LeoHougaard/robot-research-playground/hardware/electronics/watchdog-circuit.png

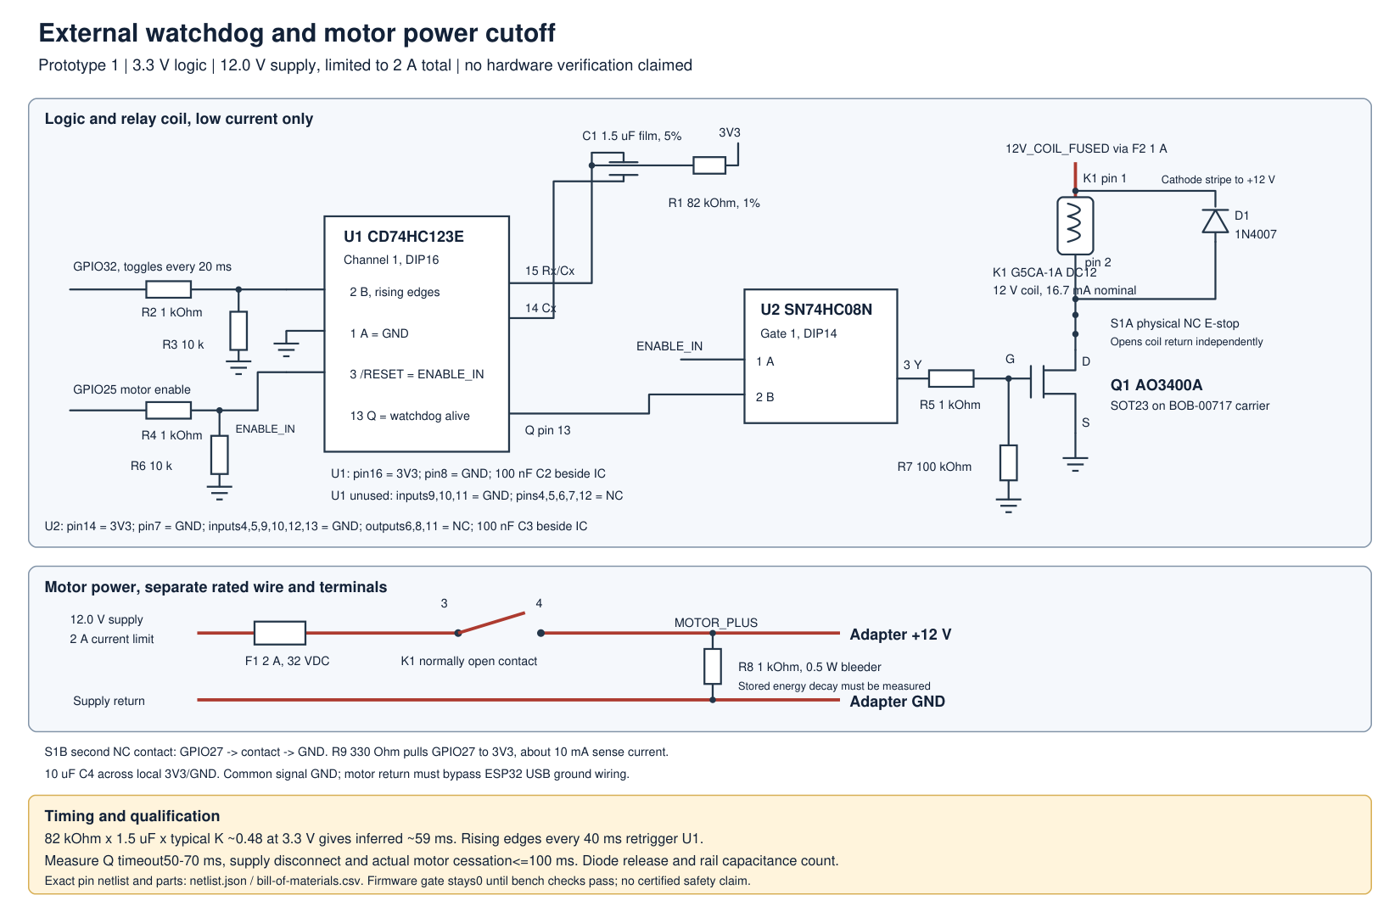
hardware/electronics/watchdog-circuit.png
