LeoHougaard/robot-research-playground/hardware/freecad/robot/previews/native_arena_top.png

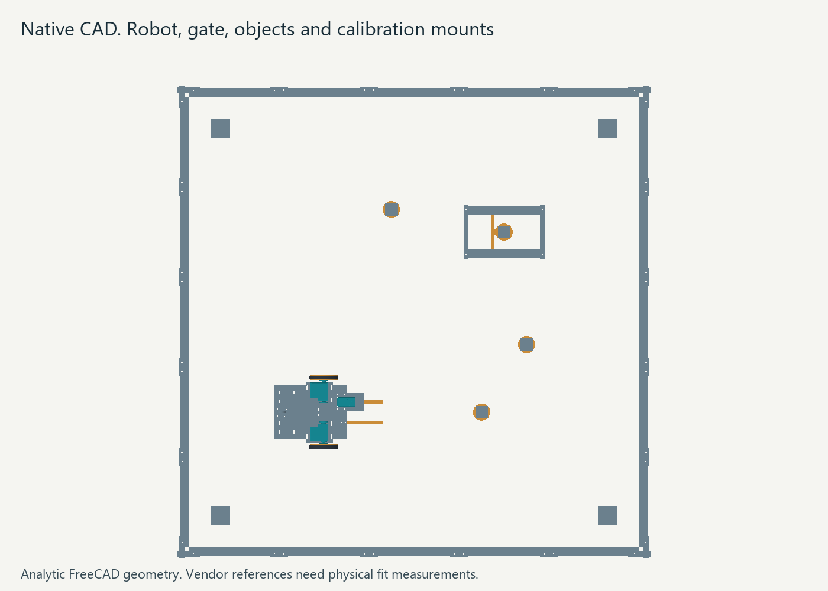
hardware/freecad/robot/previews/native_arena_top.png
