LeoHougaard/robot-research-playground/hardware/markers/aruco-markers-a4-300dpi.png

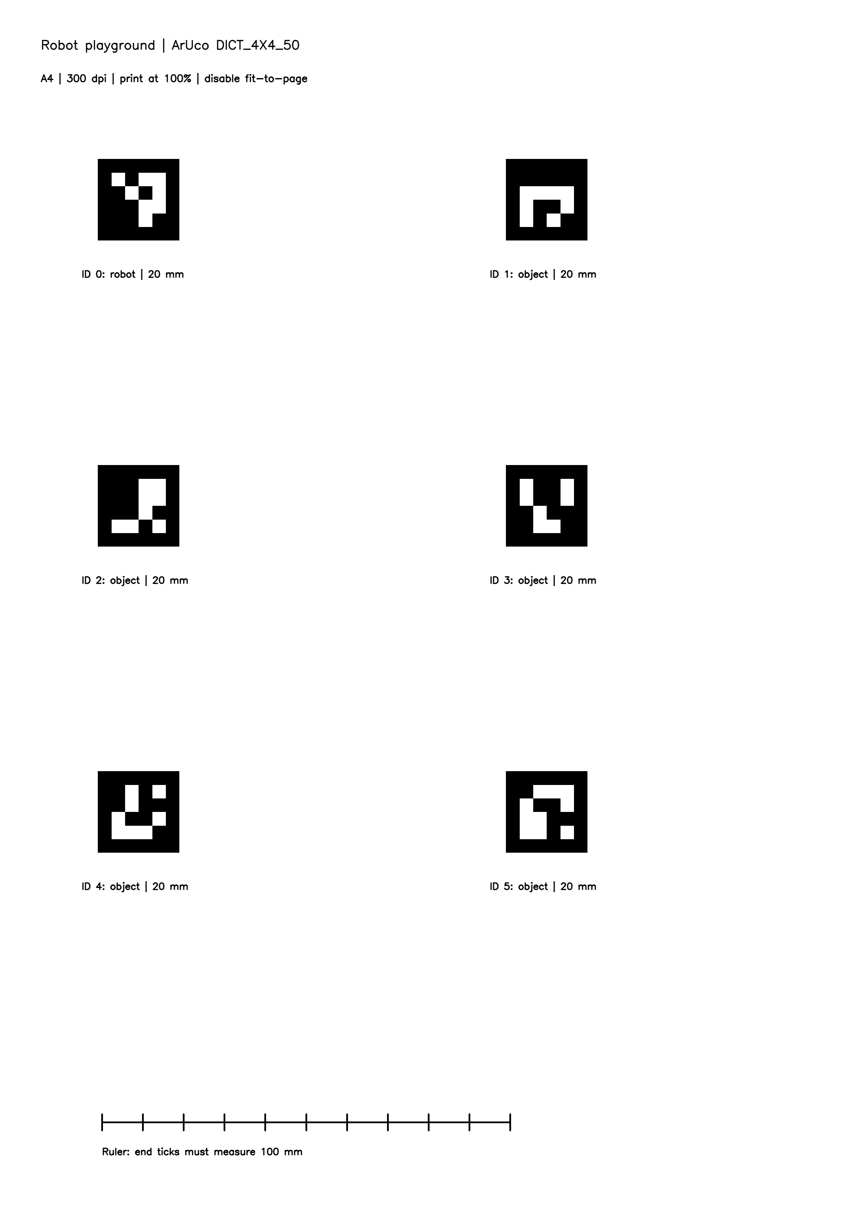
hardware/markers/aruco-markers-a4-300dpi.png
