LeoHougaard/robot-research-playground/hardware/markers/marker-0-20mm-300dpi.png

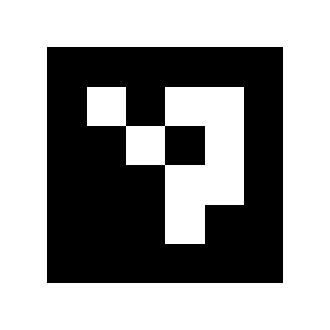
hardware/markers/marker-0-20mm-300dpi.png
