LeoHougaard/robot-research-playground/hardware/markers/marker-1-20mm-300dpi.png

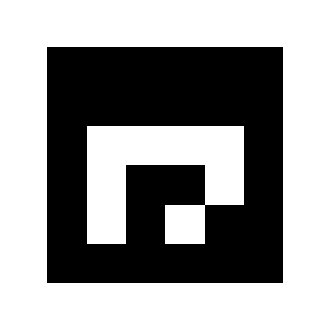
hardware/markers/marker-1-20mm-300dpi.png
