LeoHougaard/robot-research-playground/hardware/markers/marker-5-20mm-300dpi.png

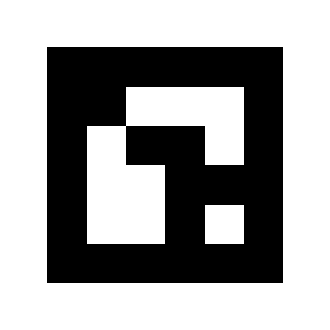
hardware/markers/marker-5-20mm-300dpi.png
