LeoHougaard/robot-research-playground/hardware/electronics/bill-of-materials.csv

Reference | Quantity | Manufacturer | Part number | Specification | Notes | Primary source
U1 | 1 | Texas Instruments | CD74HC123E | PDIP16 HC retriggerable monostable 2-6V | Use HC not HCT; power from ESP32 3.3V | https://www.ti.com/product/CD74HC123/part-details/CD74HC123E
U2 | 1 | Texas Instruments | SN74HC08N | PDIP14 quad AND gate 2-6V | Use HC not HCT; power from ESP32 3.3V | https://www.ti.com/product/SN74HC08/part-details/SN74HC08N
Q1 | 1 | Alpha and Omega Semiconductor | AO3400A | 30V N-channel MOSFET with Rds specified at 2.5V | SOT23 on carrier; switches only relay coil not motors | https://www.aosmd.com/products/mosfets/low-voltage-mosfets-12v-30v/ao3400a
Q1 carrier | 1 | SparkFun | BOB-00717 | SOT23 to DIP adapter | Verify carrier-pad continuity to actual G/S/D before soldering | https://www.sparkfun.com/sparkfun-sot23-to-dip-adapter.html
K1 | 1 | Omron / Aratas | G5CA-1A DC12 | 12V 16.7mA coil; SPST-NO 10A at30VDC resistive | 3A DC inductive rating; prototype supply limited to2A total | https://omronfs.omron.com/en_US/ecb/products/pdf/en-g5ca.pdf
D1 | 1 | Vishay | 1N4007-E3/54 | 1A axial diode | Cathode stripe to coil+12V; anode to coil low side BEFORE E-stop | https://www.vishay.com/docs/88503/1n4001.pdf
S1 | 1 | Omron | A22E-M-02 | Latching turn-reset E-stop with two NC contacts | One NC opens coil return; second NC connects GPIO27 to GND | https://www.fa.omron.co.jp/product/item/A22E-M-02/
S2 | 1 | Adafruit | 1505 | Black normally-open momentary 16mm panel button; max shaft15.56mm totalheight29.4mm | GPIO26 to GND with firmware internal pullup; nominal16mm panel hole needs physical fit check; label PRESS TO AUTHORIZE; fresh press grants window then host arm required | https://www.adafruit.com/product/1505
C1 | 1 | TDK | B32529C0155J000 | 1.5uF 63V film +/-5%; 5mm lead spacing | Timing capacitor BETWEEN U1 pins14 and15; never substitute bulk electrolytic without requalification | https://www.tdk-electronics.tdk.com/inf/20/20/db/fc_2009/B32520_529.pdf
R1 | 1 | Commodity | 82k axial metal-film 1% | 0.25W minimum | Timing resistor from U1 pin15 to3.3V; measured timing gate required | https://www.ti.com/lit/ds/symlink/cd74hc123.pdf
R2 R4 R5 | 3 | Commodity | 1k axial metal-film 1% | 0.25W minimum | GPIO32 series; GPIO25 series; MOSFET gate series
R3 R6 | 2 | Commodity | 10k axial metal-film 1% | 0.25W minimum | Pull GPIO32 input and enable/reset input down at logic ICs
R7 | 1 | Commodity | 100k axial metal-film 1% | 0.25W minimum | Gate-to-source pulldown physically beside Q1
R8 | 1 | Commodity | 1k resistor 5% | 0.5W minimum | Motor rail bleeder; does not prove fast capacitor discharge
R9 | 1 | Commodity | 330ohm resistor 5% | 0.25W minimum | External GPIO27 pullup to3.3V provides about10mA NC sense current; measure contact behavior
C2 C3 | 2 | Commodity | 100nF X7R ceramic radial | 16V minimum | One per logic IC beside supply pins
C4 | 1 | Commodity | 10uF electrolytic radial | 10V minimum | 3.3V local bulk bypass; correct polarity
F1 | 1 | Littelfuse | 0297002.WXNV | 2A MINI blade fuse rated32VDC | Motor positive branch; do not raise commissioning supply above2A | https://www.littelfuse.com/assetdocs/littelfuse-datasheet-297-mini32v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
F2 | 1 | Littelfuse | 0287001.PXCN | 1A ATOF blade fuse rated32VDC | Separate coil positive branch and appropriate holder | https://www.littelfuse.com/products/fuses-overcurrent-protection/fuses/automotive-fuses/blade-fuses-shunt
Construction | 1 | Commodity | Isolated-pad perfboard plus DIP14 and DIP16 sockets | Offboard electronics in enclosure | Motor current runs through soldered heavy wire and rated terminals; no breadboard motor paths
