LeoHougaard/robot-research-playground/hardware/prints/print_manifest.csv

part | quantity | material | orientation
01_horn_fit_coupon | 1 | PETG | flat; compare all four holes to the stock horn
02_hole_clearance_coupon | 1 | PETG | flat; hole sequence left to right 2.5,2.8,3.0,3.2,3.4 mm
03_servo_body_coupon | 1 | PETG | flat; open gap is40.2 mm
04_gate_rail_coupon | 1 | PETG | flat; same retaining lip as full gate, supports under lip
05_gate_runner_coupon | 1 | PETG | flat; slide through coupon channel before printing full gate
10_chassis | 1 | PETG | flat bottom; no supports
11_drive_servo_cradle | 2 | PETG | flat bottom; no supports
12_drive_wheel | 2 | PETG | flat side; no supports
13_tpu_tire | 2 | TPU95A | flat ring; no supports
14_caster_spacer | 1 | PETG | flat; nominal3.9 mm
15_caster_shim_05 | 1 | PETG | flat; optional leveling
16_caster_shim_10 | 1 | PETG | flat; optional leveling
20_moving_jaw | 1 | PETG | flat; no supports
21_fixed_jaw | 1 | PETG | flat jaw bottom; no supports
22_gripper_servo_tower | 1 | PETG | flat bottom; cable-window bridge and strap slots may need supports
30_marker_tower | 1 | PETG | marker plate on bed; turn over for assembly
31_tether_mast | 1 | PETG | upright with brim; support inside eye or print on side with supports
32_overhead_tie_plate | 1 | PETG | flat plate; eye needs support
40_puck | 3 | PETG | flat; vary color by object, keep shape unchanged
41_object_marker_cap | 8 | PETG | plate on bed, stem upward; invert and glue into puck, gate, or calibration socket
42_calibration_marker_base | 4 | PETG | flat; same74 mm tagplane as robot and objects
50_gate_base | 1 | PETG | flat bottom; rail lips need support, remove support from channels
51_gate_slider | 1 | PETG | supports under runners and rear bridge; ensure all support is removable
52_gate_end_stop | 4 | PETG | flat; one block per rail at each end, no supports
60_arena_wall_200 | 20 | PETG | flat foot; inside face at localY=0, foot points outside
61_wall_joiner | 16 | PETG | flat; use on top of adjacent feet
62_arena_corner | 4 | PETG | flat; use on top of feet at frame corners
