LeoHougaard/robot-research-playground/hardware/prints/accessories/print_manifest.csv

part | quantity | material | orientation | stl_path | print_rotation_xyz_deg | print_translation_mm | native_bounds_mm
electronics_box | 1 | PETG | Floor on bed; open box upward | hardware/prints/accessories/electronics_box.stl | [0, 0, 0] | [0, 0, -0.0] | [[0.0, 0.0, 0.0], [200.0, 130.0, 65.0]]
electronics_lid | 1 | PETG | Outer flat face on bed; retaining lip upward | hardware/prints/accessories/electronics_lid.stl | [180, 0, 0] | [0, 0, 3.0] | [[0.0, 0.0, -4.0], [200.0, 130.0, 3.0]]
perfboard_carrier | 1 | PETG | Largest flat face on bed | hardware/prints/accessories/perfboard_carrier.stl | [0, 0, 0] | [0, 0, -0.0] | [[-1.3322676295501878e-15, -3.552713678800501e-15, 0.0], [186.0, 116.0, 4.0]]
camera_plate | 1 | PETG | Largest flat face on bed | hardware/prints/accessories/camera_plate.stl | [0, 0, 0] | [0, 0, -0.0] | [[0.0, 0.0, 0.0], [140.0, 100.0, 8.0]]
beam_clamp_lower | 2 | PETG | Flat outer back on bed; groove upward | hardware/prints/accessories/beam_clamp_lower.stl | [0, 0, 0] | [0, 0, -0.0] | [[0.0, 0.0, 0.0], [80.0, 54.0, 16.0]]
beam_clamp_upper | 2 | PETG | Flat outer back on bed; groove upward | hardware/prints/accessories/beam_clamp_upper.stl | [0, 0, 0] | [0, 0, -0.0] | [[0.0, 0.0, 0.0], [80.0, 54.0, 16.0]]
tether_anchor_plate | 1 | PETG | Flat plate on bed; cord is secondary restraint only | hardware/prints/accessories/tether_anchor_plate.stl | [0, 0, 0] | [0, 0, -0.0] | [[0.0, 0.0, 0.0], [80.0, 30.0, 5.0]]
cable_clamp_lower | 1 | PETG | Flat back on bed; groove upward | hardware/prints/accessories/cable_clamp_lower.stl | [0, 0, 0] | [0, 0, -0.0] | [[-6.439293542825908e-16, 0.0, 0.0], [50.0, 22.0, 8.000000000000014]]
cable_clamp_upper | 1 | PETG | Flat back on bed; groove upward | hardware/prints/accessories/cable_clamp_upper.stl | [0, 0, 0] | [0, 0, -0.0] | [[-6.439293542825908e-16, 0.0, 0.0], [50.0, 22.0, 8.000000000000014]]
estop_panel | 1 | PETG | Flat rear on bed; use supplied Omron locking plate, no printed certification claim | hardware/prints/accessories/estop_panel.stl | [0, 0, 0] | [0, 0, -0.0] | [[0.0, 0.0, 0.0], [120.0, 160.0, 3.0]]
estop_clearance_ring | 1 | PETG | Flat ring on bed; optional low ring, check palm access and twist-release | hardware/prints/accessories/estop_clearance_ring.stl | [0, 0, 0] | [0, 0, -0.0] | [[-47.0, -40.0, 0.0], [47.0, 40.0, 5.000000000000001]]
estop_panel_stand | 1 | PETG | Floor on bed; secure to desk/support; open sides give rear terminal access | hardware/prints/accessories/estop_panel_stand.stl | [0, 0, 0] | [0, 0, -0.0] | [[0.0, 0.0, 0.0], [140.0, 180.0, 76.0]]
terminal_guard | 1 | PETG | Flat floor on bed; low-voltage terminal shielding only | hardware/prints/accessories/terminal_guard.stl | [0, 0, 0] | [0, 0, -0.0] | [[0.0, 0.0, 0.0], [90.0, 24.0, 22.0]]
