LeoHougaard/robot-research-playground/hardware/prints/parts_inventory.png

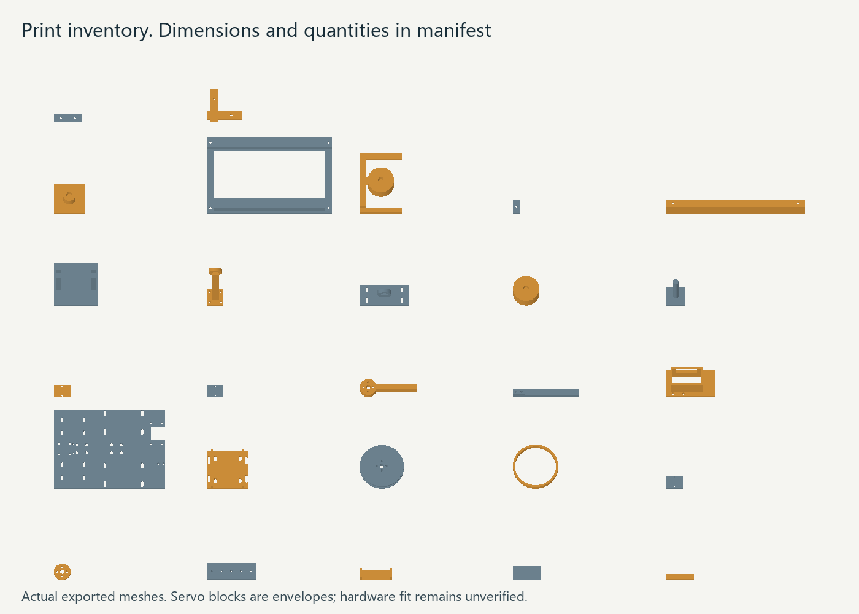
hardware/prints/parts_inventory.png
