LeoHougaard/robot-research-playground/hardware/native/accessories/tether_assembly.FCStd

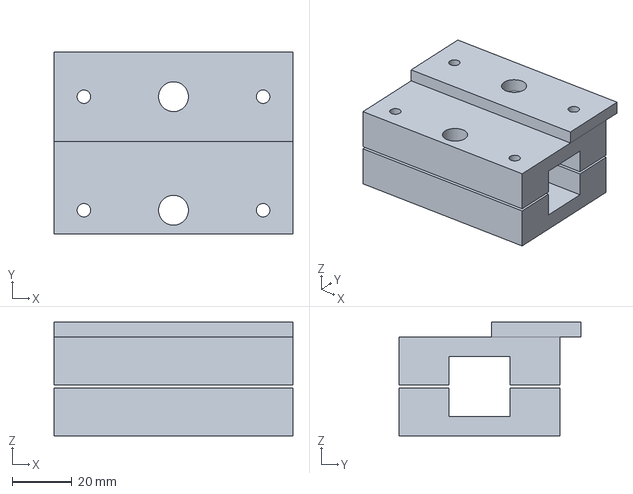
[picture p18: CAD file, 2026-10-13]
hardware/native/accessories/tether_assembly.FCStd
80.0 x 61.0 x 38.0 mm
