LeoHougaard/robot-research-playground/hardware/step/robot/robot_playground_assembly.step

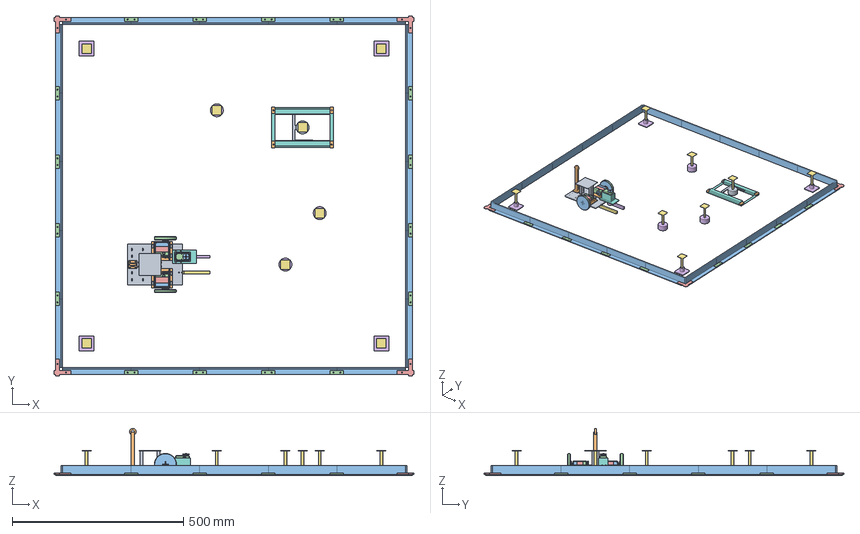
[picture p19: CAD file, 2026-10-13]
hardware/step/robot/robot_playground_assembly.step
1050.0 x 1050.0 x 138.0 mm
10_chassis
11_drive_servo_cradle x 2
12_drive_wheel x 2
13_tpu_tire x 2
14_caster_spacer
20_moving_jaw
21_fixed_jaw
22_gripper_servo_tower
30_marker_tower
31_tether_mast
ST3020 drive servo vendor reference -1 x 3
Pololu950 caster vendor reference
40_puck x 3
41_object_marker_cap x 8
50_gate_base
51_gate_slider
52_gate_end_stop x 4
60_arena_wall_200 x 20
61_wall_joiner x 16
62_arena_corner x 4
42_calibration_marker_base x 4
