LeoHougaard/robot-research-playground/hardware/native/accessories/camera_assembly.FCStd

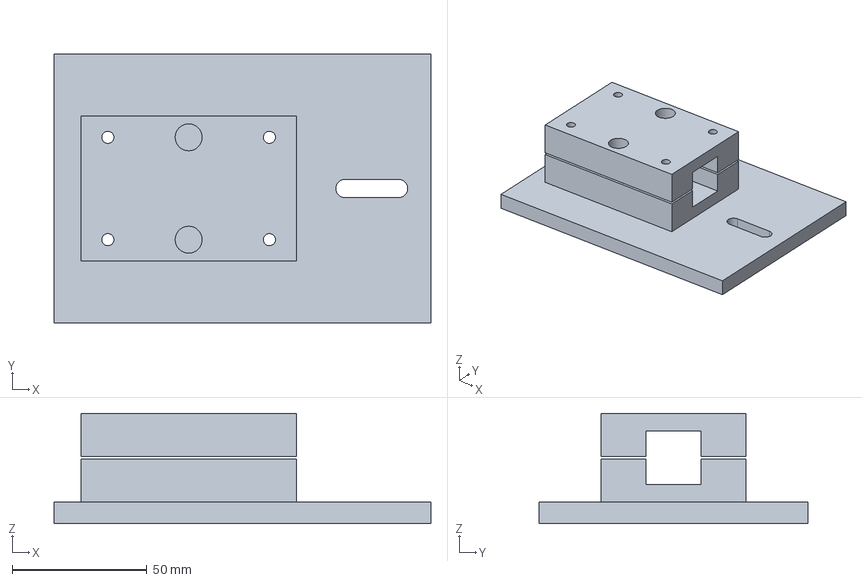
[picture p20: CAD file, 2026-10-13]
hardware/native/accessories/camera_assembly.FCStd
140.0 x 100.0 x 41.0 mm
