LeoHougaard/robot-research-playground/hardware/step/accessories/cable_assembly.step

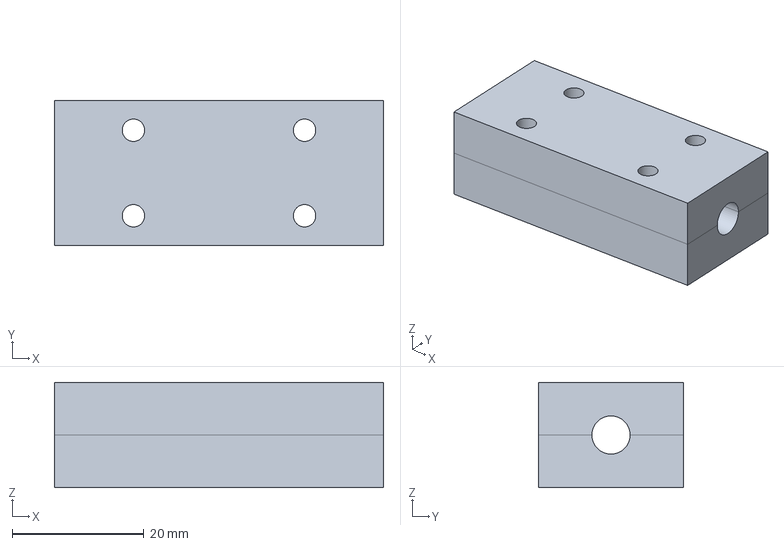
[picture p21: CAD file, 2026-10-13]
hardware/step/accessories/cable_assembly.step
50.0 x 22.0 x 16.0 mm
