LeoHougaard/robot-research-playground/hardware/native/accessories/operator_panel_assembly.FCStd

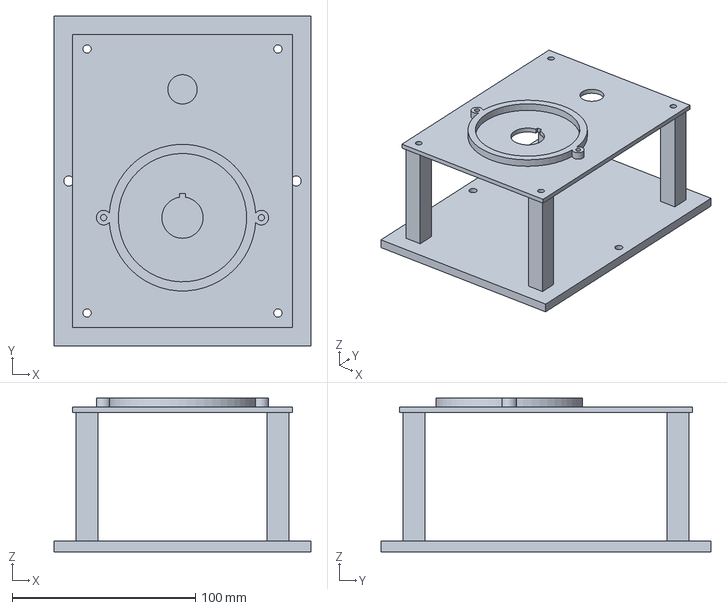
[picture p22: CAD file, 2026-10-13]
hardware/native/accessories/operator_panel_assembly.FCStd
140.0 x 180.0 x 84.0 mm
