LeoHougaard/robot-research-playground/hardware/step/accessories/electronics_assembly.step

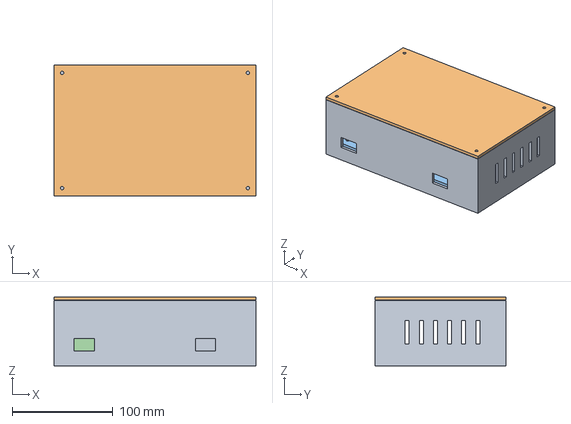
[picture p23: CAD file, 2026-10-13]
hardware/step/accessories/electronics_assembly.step
200.0 x 130.0 x 68.3 mm
