LeoHougaard/robot-research-playground/hardware/freecad/robot/pololu950.step

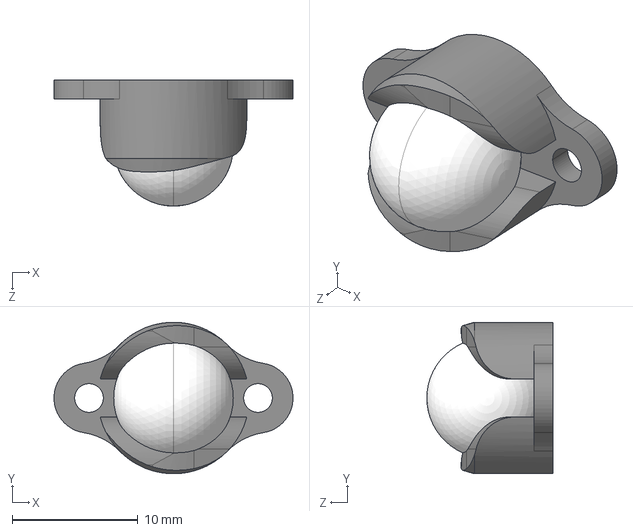
[picture p24: CAD file, 2026-10-13]
hardware/freecad/robot/pololu950.step
19.0 x 12.1 x 10.1 mm
