LeoHougaard/robot-research-playground/hardware/native/accessories/cable_clamp_lower.FCStd

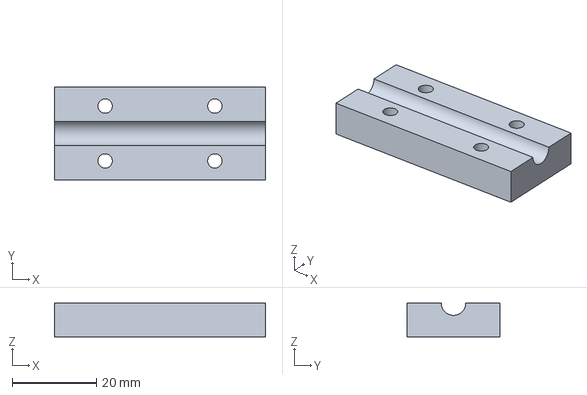
[picture p25: CAD file, 2026-10-13]
hardware/native/accessories/cable_clamp_lower.FCStd
50.0 x 22.0 x 8.00 mm
