LeoHougaard/robot-research-playground/hardware/native/robot/12_drive_wheel.FCStd

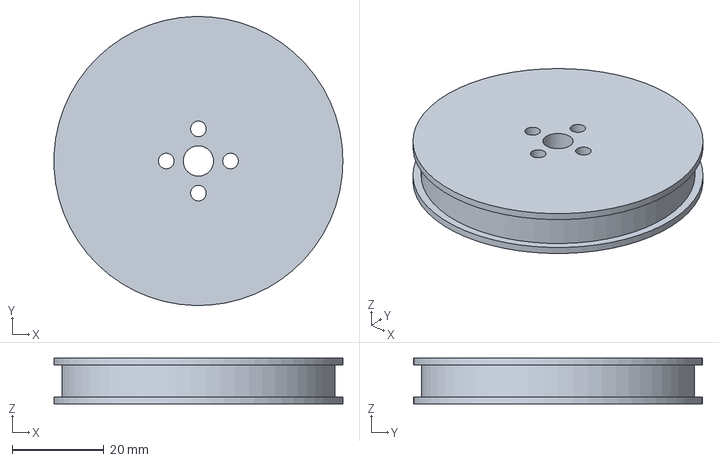
[picture p26: CAD file, 2026-10-13]
hardware/native/robot/12_drive_wheel.FCStd
63.0 x 63.0 x 10.0 mm
