LeoHougaard/robot-research-playground/hardware/step/accessories/electronics_lid.step

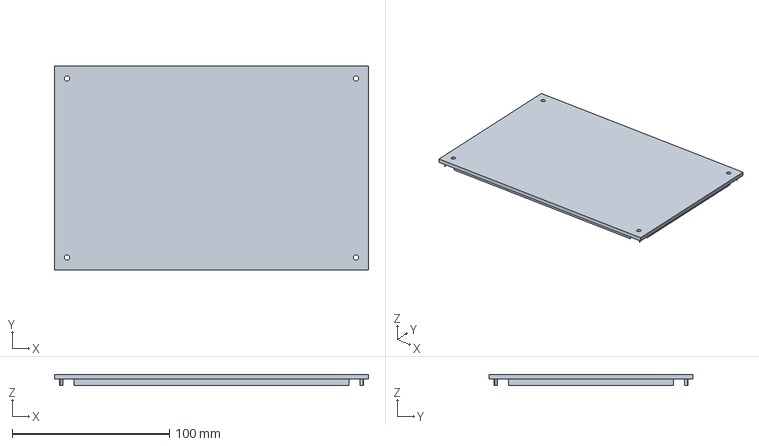
[picture p27: CAD file, 2026-10-13]
hardware/step/accessories/electronics_lid.step
200.0 x 130.0 x 7.00 mm
