LeoHougaard/robot-research-playground/hardware/step/robot/41_object_marker_cap.step

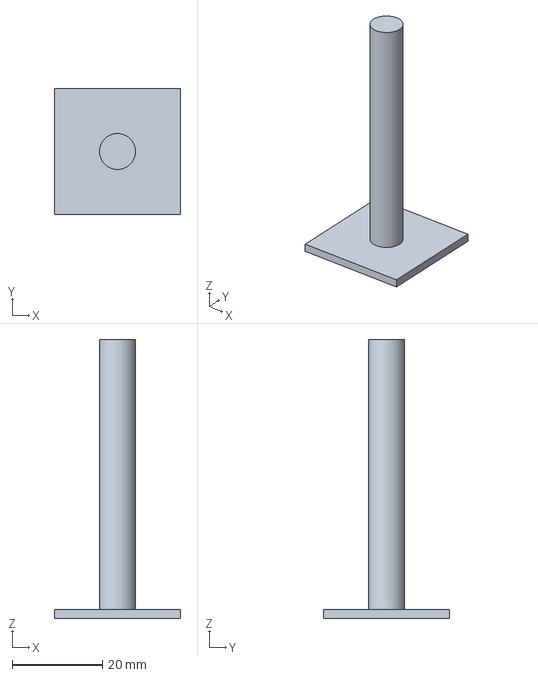
[picture p28: CAD file, 2026-10-13]
hardware/step/robot/41_object_marker_cap.step
28.0 x 28.0 x 62.0 mm
