LeoHougaard/robot-research-playground/hardware/native/robot/60_arena_wall_200.FCStd

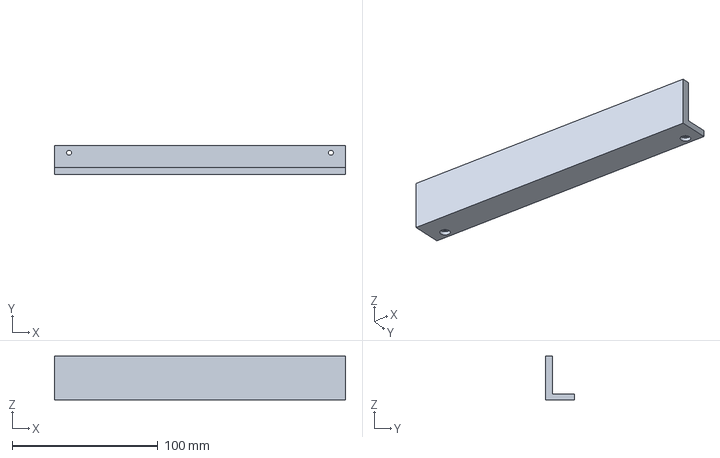
[picture p29: CAD file, 2026-10-13]
hardware/native/robot/60_arena_wall_200.FCStd
200.0 x 20.0 x 30.0 mm
