LeoHougaard/robot-research-playground/hardware/prints/62_arena_corner.stl

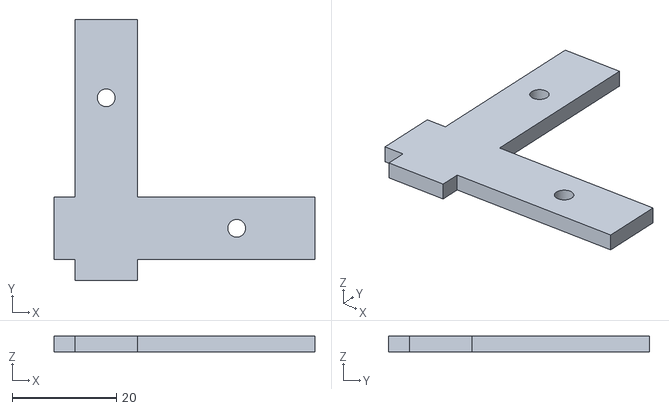
[picture p30: CAD file, 2026-10-13]
hardware/prints/62_arena_corner.stl
50.0 x 50.0 x 3.00
