LeoHougaard/robot-research-playground/hardware/step/accessories/camera_plate.step

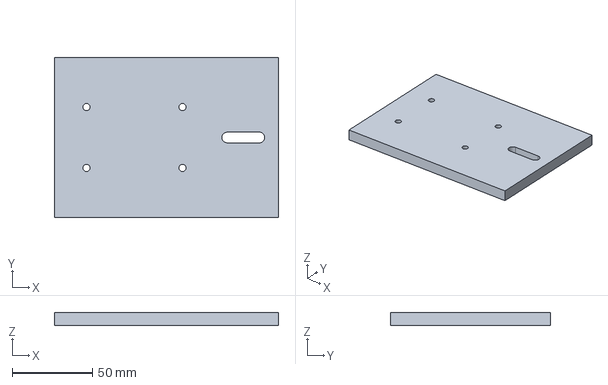
[picture p31: CAD file, 2026-10-13]
hardware/step/accessories/camera_plate.step
140.0 x 100.0 x 8.00 mm
