LeoHougaard/robot-research-playground/hardware/native/robot/16_caster_shim_10.FCStd

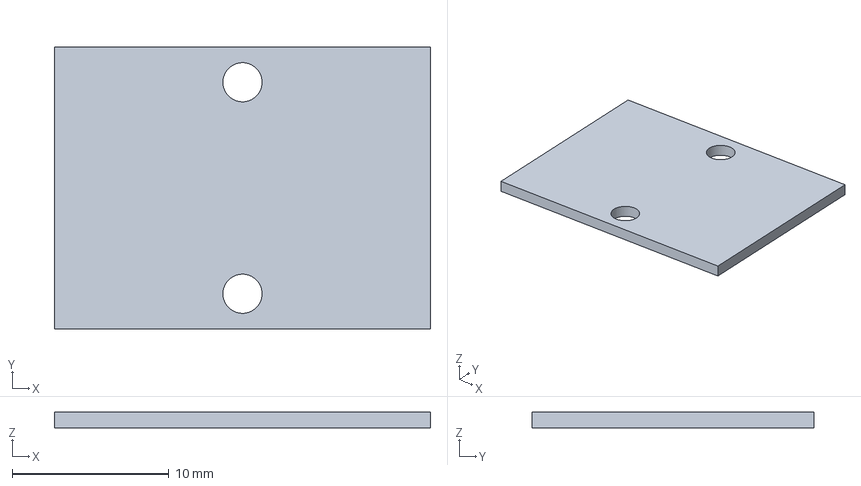
[picture p32: CAD file, 2026-10-13]
hardware/native/robot/16_caster_shim_10.FCStd
24.0 x 18.0 x 1.00 mm
