LeoHougaard/robot-research-playground/hardware/prints/03_servo_body_coupon.stl

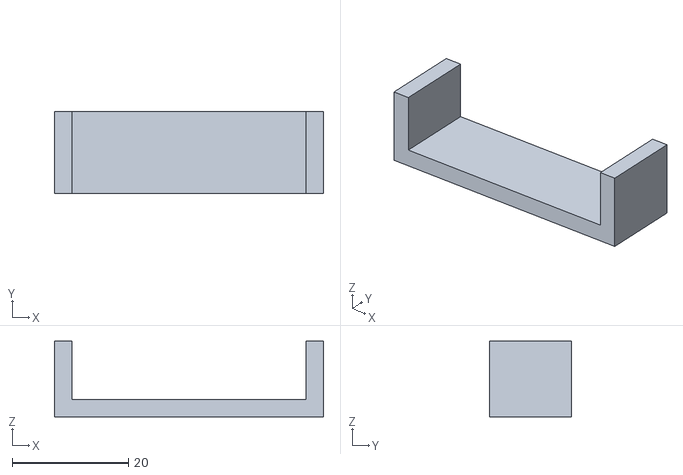
[picture p33: CAD file, 2026-10-13]
hardware/prints/03_servo_body_coupon.stl
46.2 x 14.0 x 13.0
