LeoHougaard/robot-research-playground/hardware/step/accessories/estop_panel_stand.step

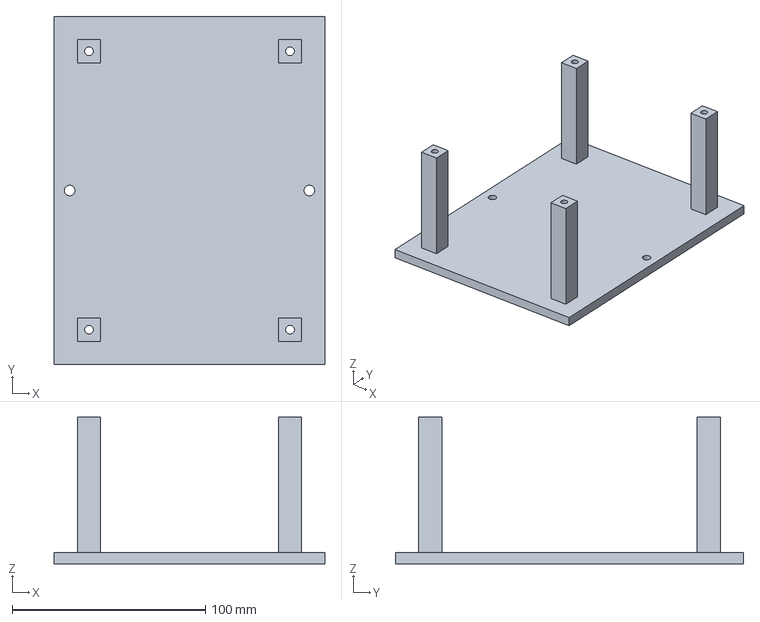
[picture p34: CAD file, 2026-10-13]
hardware/step/accessories/estop_panel_stand.step
140.0 x 180.0 x 76.0 mm
