LeoHougaard/robot-research-playground/hardware/native/accessories/estop_clearance_ring.FCStd

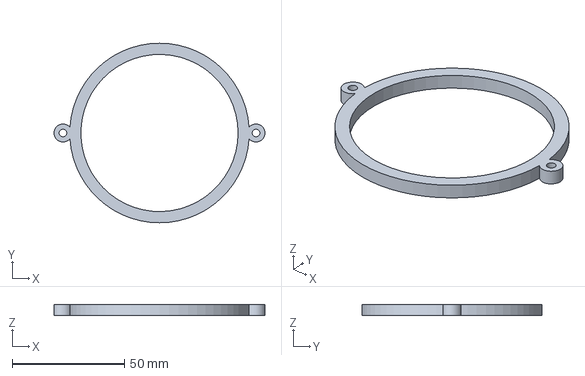
[picture p35: CAD file, 2026-10-13]
hardware/native/accessories/estop_clearance_ring.FCStd
94.0 x 80.0 x 5.00 mm
