LeoHougaard/robot-research-playground/hardware/native/robot/01_horn_fit_coupon.FCStd

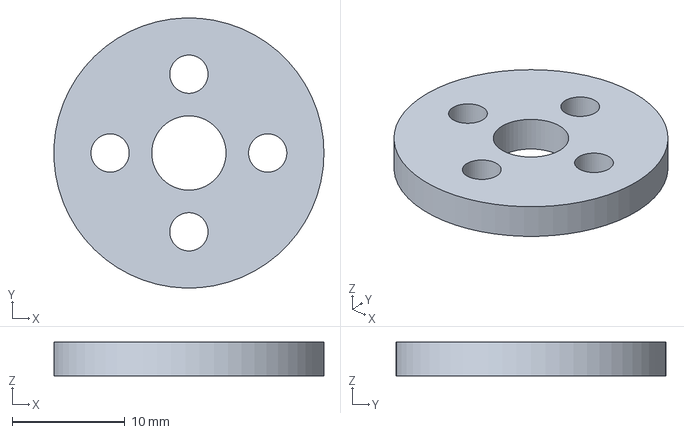
[picture p36: CAD file, 2026-10-13]
hardware/native/robot/01_horn_fit_coupon.FCStd
24.0 x 24.0 x 3.00 mm
