LeoHougaard/robot-research-playground/hardware/prints/21_fixed_jaw.stl

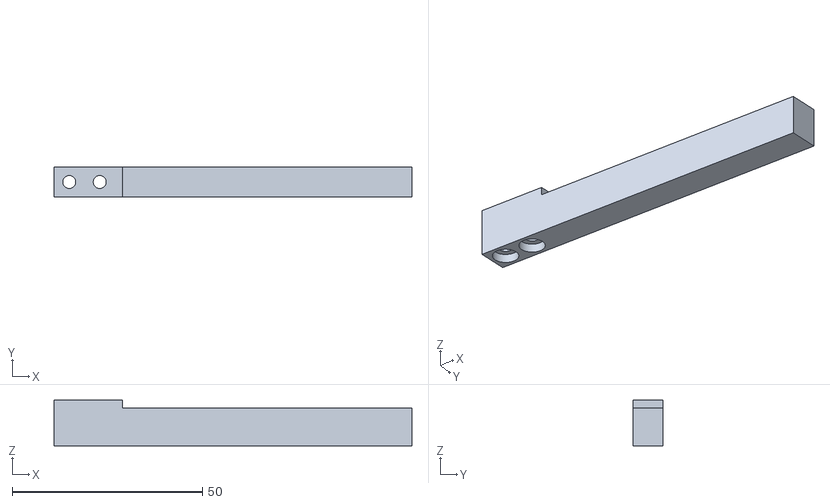
[picture p37: CAD file, 2026-10-13]
hardware/prints/21_fixed_jaw.stl
94.0 x 8.00 x 12.0
