LeoHougaard/robot-research-playground/hardware/step/accessories/terminal_guard.step

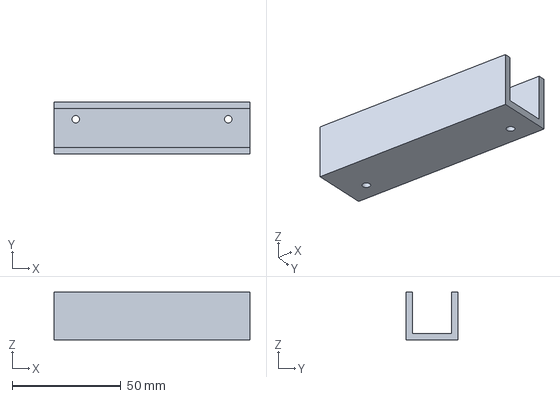
[picture p38: CAD file, 2026-10-13]
hardware/step/accessories/terminal_guard.step
90.0 x 24.0 x 22.0 mm
