LeoHougaard/robot-research-playground/hardware/step/robot/11_drive_servo_cradle.step

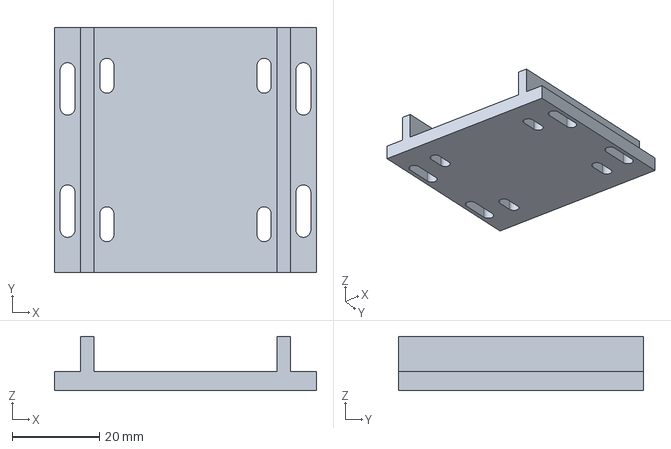
[picture p39: CAD file, 2026-10-13]
hardware/step/robot/11_drive_servo_cradle.step
60.0 x 56.0 x 12.4 mm
