LeoHougaard/robot-research-playground/hardware/prints/02_hole_clearance_coupon.stl

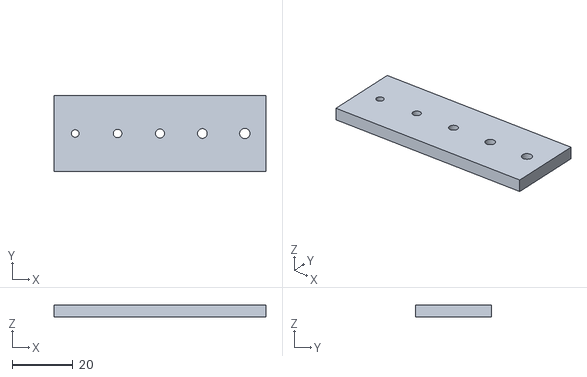
[picture p40: CAD file, 2026-10-13]
hardware/prints/02_hole_clearance_coupon.stl
70.0 x 25.0 x 4.00
