LeoHougaard/robot-research-playground/hardware/native/accessories/electronics_box.FCStd

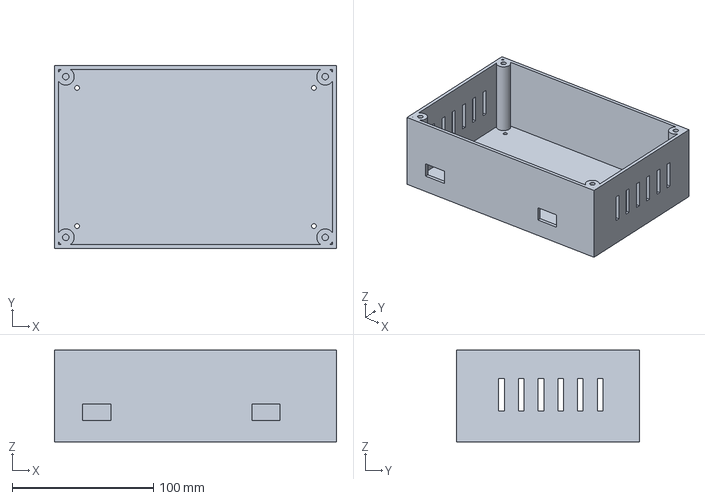
[picture p41: CAD file, 2026-10-13]
hardware/native/accessories/electronics_box.FCStd
200.0 x 130.0 x 65.0 mm
