LeoHougaard/robot-research-playground/hardware/prints/22_gripper_servo_tower.stl

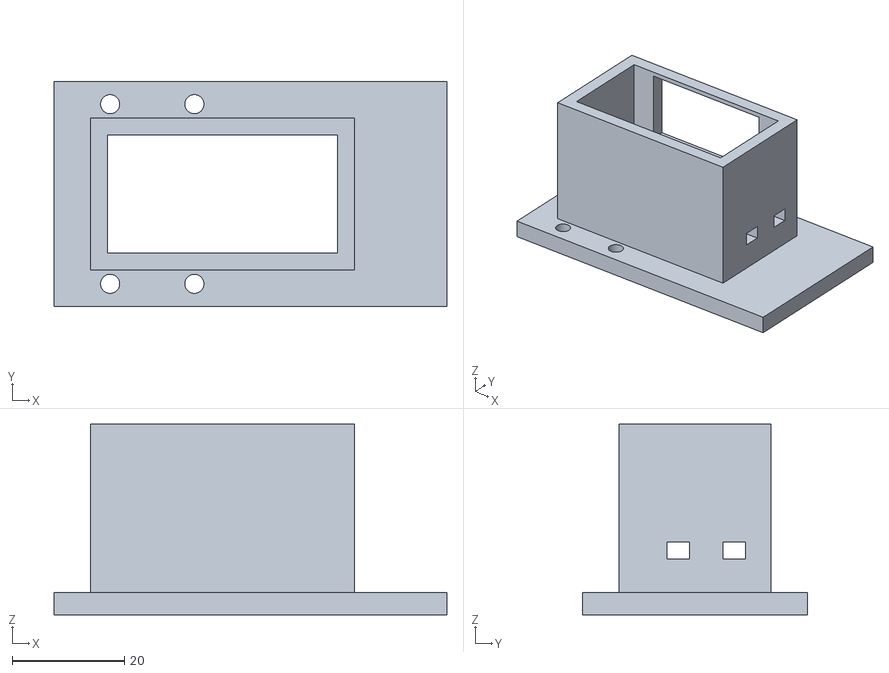
[picture p42: CAD file, 2026-10-13]
hardware/prints/22_gripper_servo_tower.stl
70.0 x 40.0 x 34.0
