LeoHougaard/robot-research-playground/hardware/step/accessories/perfboard_carrier.step

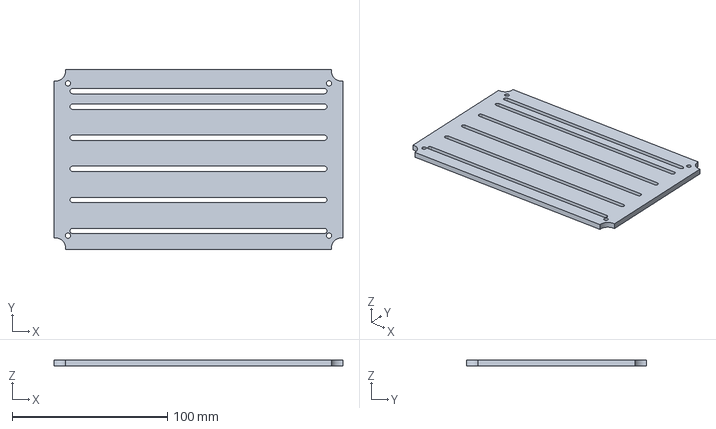
[picture p43: CAD file, 2026-10-13]
hardware/step/accessories/perfboard_carrier.step
186.0 x 116.0 x 4.00 mm
