LeoHougaard/robot-research-playground/hardware/step/robot/61_wall_joiner.step

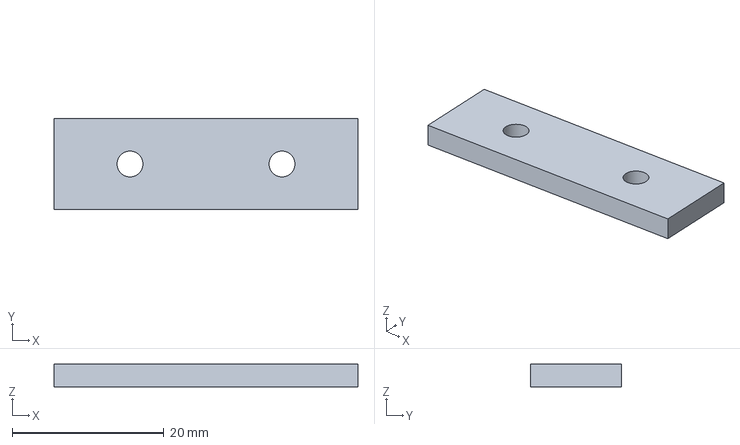
[picture p44: CAD file, 2026-10-13]
hardware/step/robot/61_wall_joiner.step
40.0 x 12.0 x 3.00 mm
