LeoHougaard/robot-research-playground/hardware/native/accessories/tether_anchor_plate.FCStd

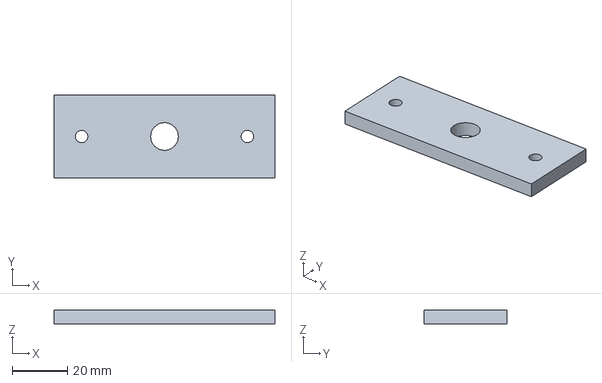
[picture p45: CAD file, 2026-10-13]
hardware/native/accessories/tether_anchor_plate.FCStd
80.0 x 30.0 x 5.00 mm
