LeoHougaard/robot-research-playground/hardware/native/robot/51_gate_slider.FCStd

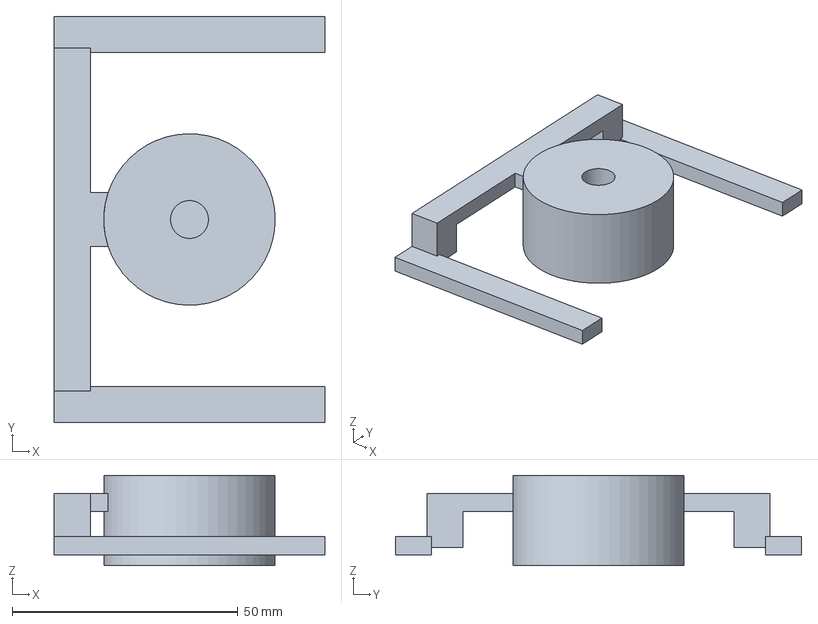
[picture p46: CAD file, 2026-10-13]
hardware/native/robot/51_gate_slider.FCStd
60.0 x 90.0 x 20.0 mm
