LeoHougaard/robot-research-playground/hardware/step/robot/20_moving_jaw.step

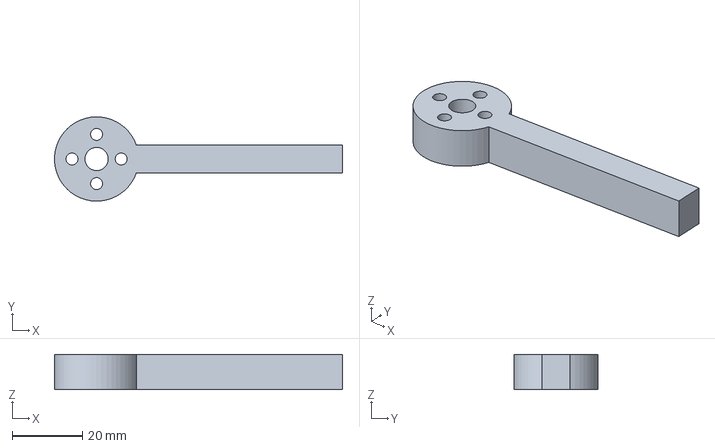
[picture p47: CAD file, 2026-10-13]
hardware/step/robot/20_moving_jaw.step
82.0 x 24.0 x 10.0 mm
