LeoHougaard/robot-research-playground/hardware/native/accessories/beam_clamp_upper.FCStd

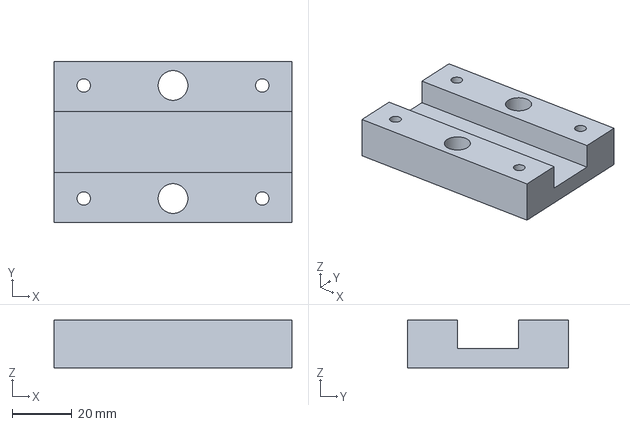
[picture p48: CAD file, 2026-10-13]
hardware/native/accessories/beam_clamp_upper.FCStd
80.0 x 54.0 x 16.0 mm
