LeoHougaard/robot-research-playground/hardware/native/robot/10_chassis.FCStd

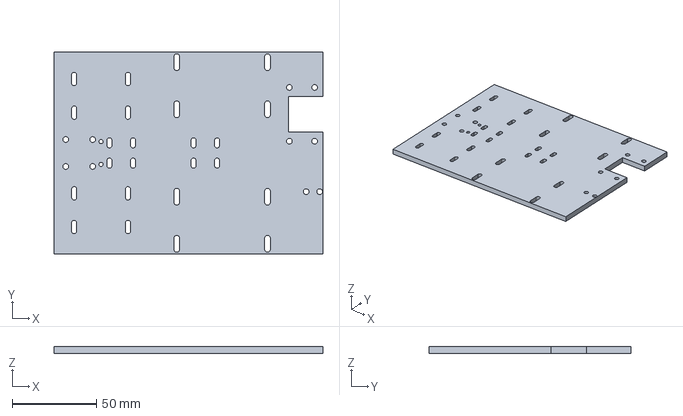
[picture p49: CAD file, 2026-10-13]
hardware/native/robot/10_chassis.FCStd
160.0 x 120.0 x 4.00 mm
