LeoHougaard/robot-research-playground/hardware/step/robot/31_tether_mast.step

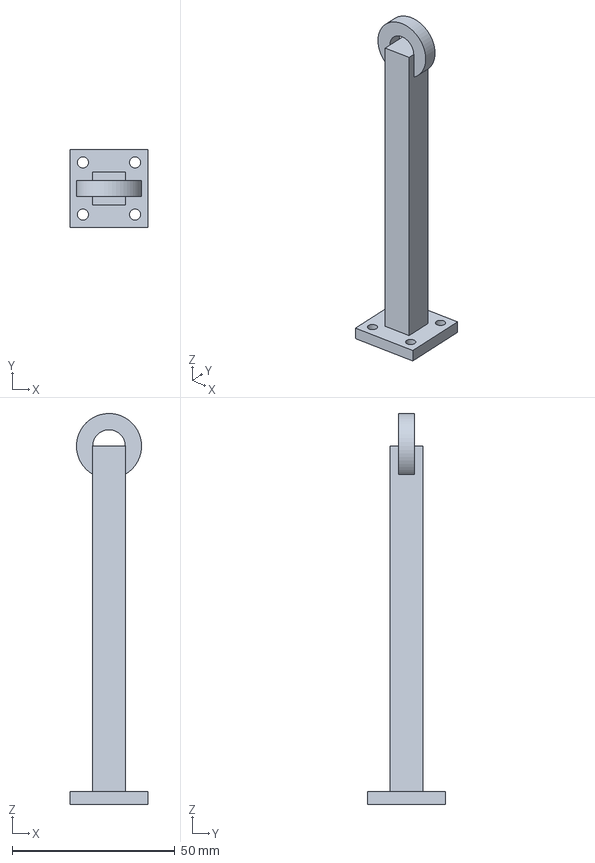
[picture p50: CAD file, 2026-10-13]
hardware/step/robot/31_tether_mast.step
24.0 x 24.0 x 120.0 mm
