LeoHougaard/robot-research-playground/hardware/prints/32_overhead_tie_plate.stl

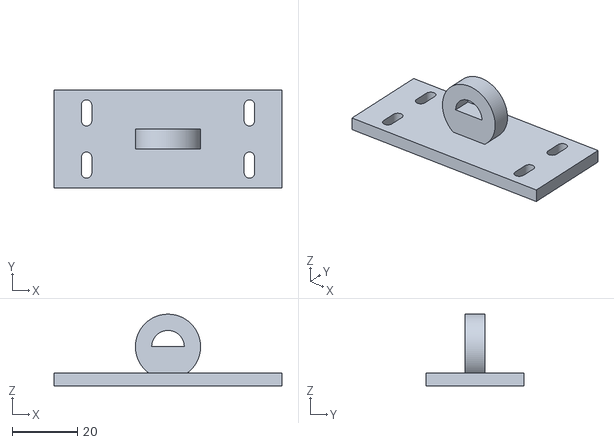
[picture p51: CAD file, 2026-10-13]
hardware/prints/32_overhead_tie_plate.stl
70.0 x 30.0 x 22.0
