LeoHougaard/robot-research-playground/hardware/step/robot/42_calibration_marker_base.step

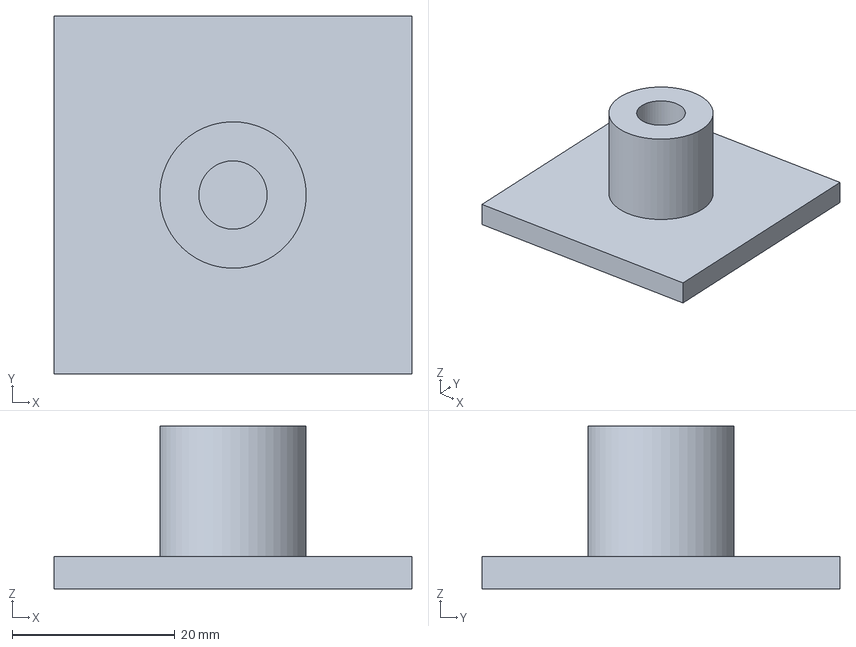
[picture p52: CAD file, 2026-10-13]
hardware/step/robot/42_calibration_marker_base.step
44.0 x 44.0 x 20.0 mm
