LeoHougaard/robot-research-playground/hardware/native/robot/30_marker_tower.FCStd

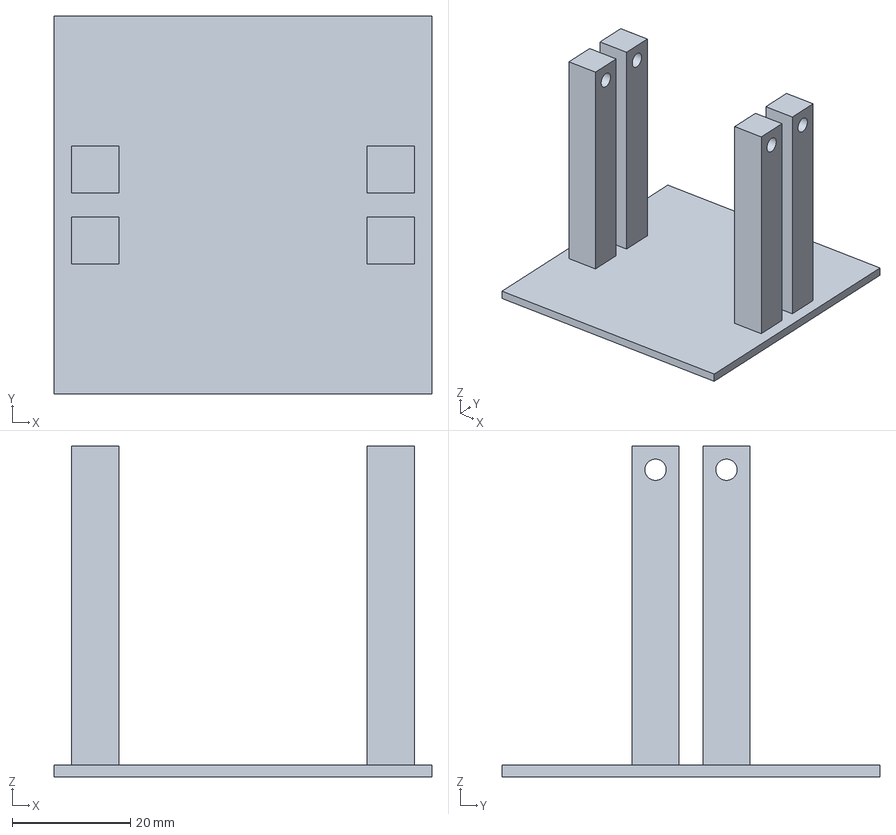
[picture p53: CAD file, 2026-10-13]
hardware/native/robot/30_marker_tower.FCStd
64.0 x 64.0 x 56.0 mm
