LeoHougaard/robot-research-playground/hardware/step/robot/15_caster_shim_05.step

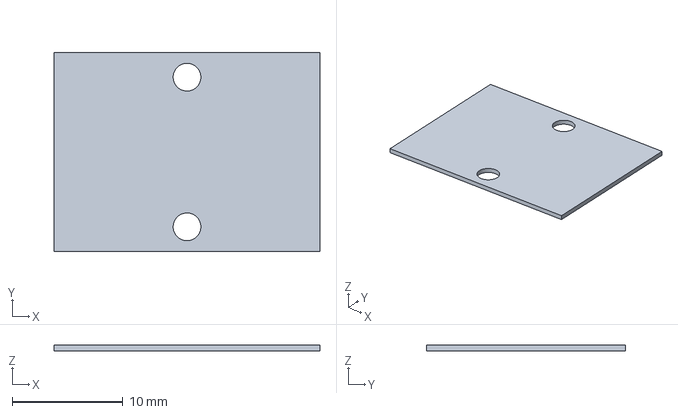
[picture p54: CAD file, 2026-10-13]
hardware/step/robot/15_caster_shim_05.step
24.0 x 18.0 x 0.5 mm
