LeoHougaard/robot-research-playground/hardware/native/robot/52_gate_end_stop.FCStd

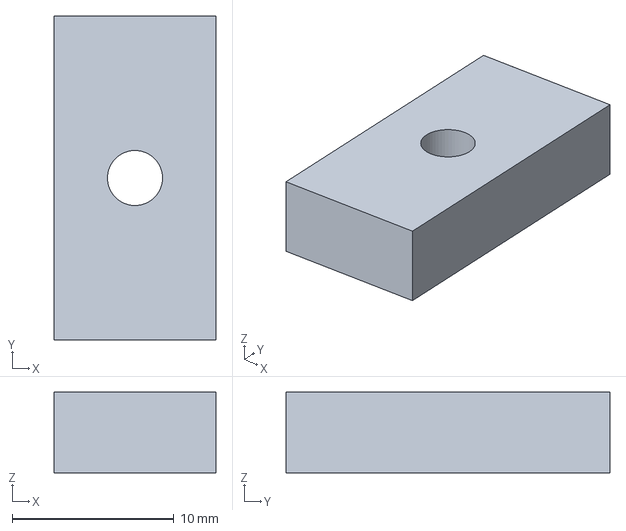
[picture p55: CAD file, 2026-10-13]
hardware/native/robot/52_gate_end_stop.FCStd
10.0 x 20.0 x 5.00 mm
