LeoHougaard/robot-research-playground/hardware/prints/13_tpu_tire.stl

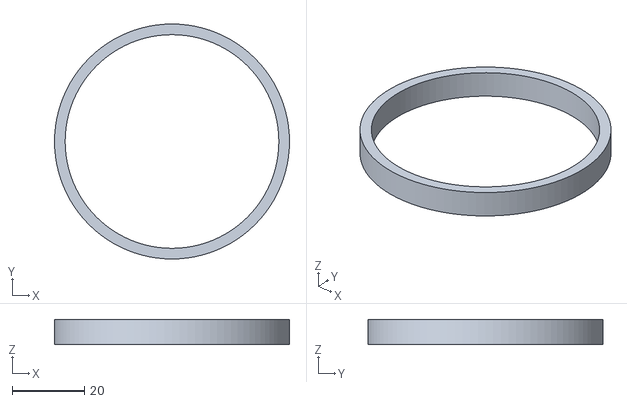
[picture p56: CAD file, 2026-10-13]
hardware/prints/13_tpu_tire.stl
65.0 x 65.0 x 7.00
