LeoHougaard/robot-research-playground/hardware/native/robot/14_caster_spacer.FCStd

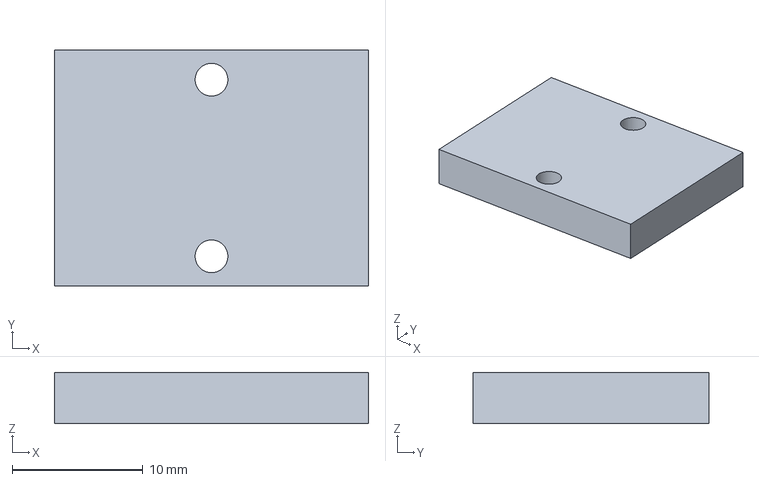
[picture p57: CAD file, 2026-10-13]
hardware/native/robot/14_caster_spacer.FCStd
24.0 x 18.0 x 3.90 mm
