LeoHougaard/robot-research-playground/hardware/prints/05_gate_runner_coupon.stl

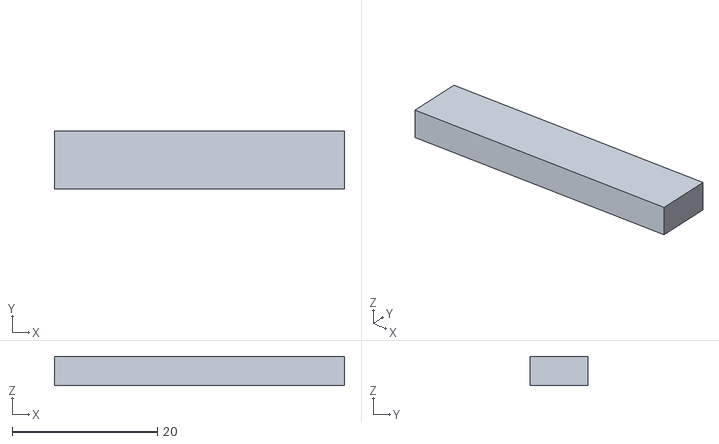
[picture p58: CAD file, 2026-10-13]
hardware/prints/05_gate_runner_coupon.stl
40.0 x 8.00 x 4.00
