LeoHougaard/robot-research-playground/hardware/step/robot/50_gate_base.step

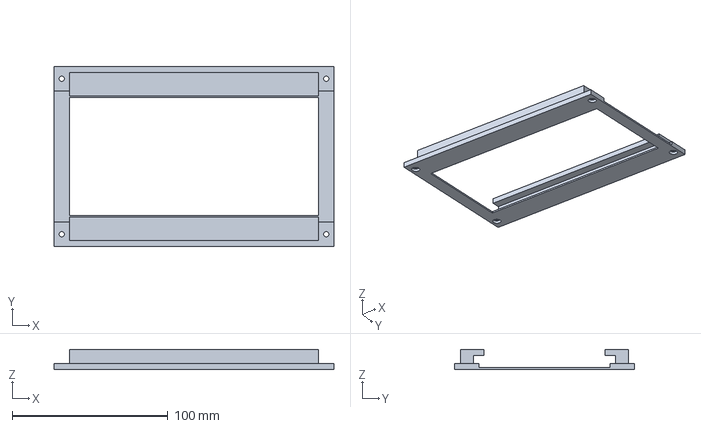
[picture p59: CAD file, 2026-10-13]
hardware/step/robot/50_gate_base.step
180.0 x 116.0 x 13.0 mm
