LeoHougaard/robot-research-playground/hardware/native/accessories/estop_panel.FCStd

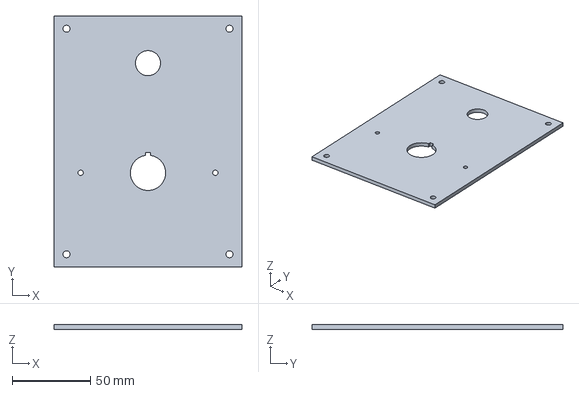
[picture p60: CAD file, 2026-10-13]
hardware/native/accessories/estop_panel.FCStd
120.0 x 160.0 x 3.00 mm
