LeoHougaard/robot-research-playground/hardware/prints/40_puck.stl

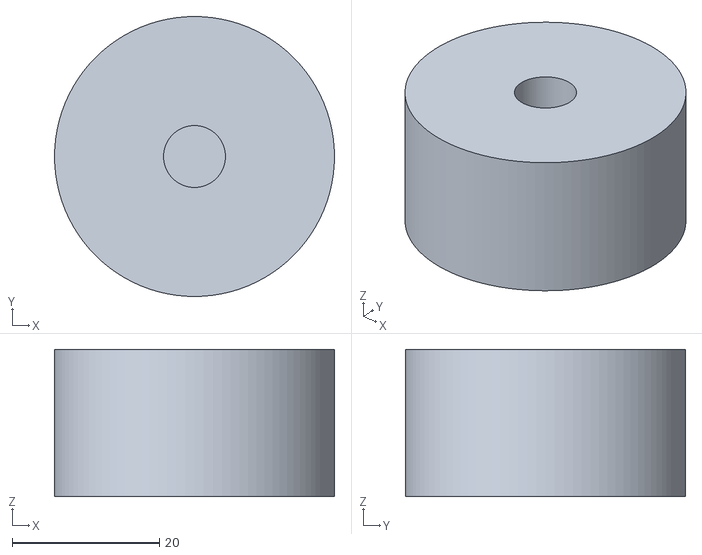
[picture p61: CAD file, 2026-10-13]
hardware/prints/40_puck.stl
38.0 x 38.0 x 20.0
