LeoHougaard/robot-research-playground/hardware/step/robot/04_gate_rail_coupon.step

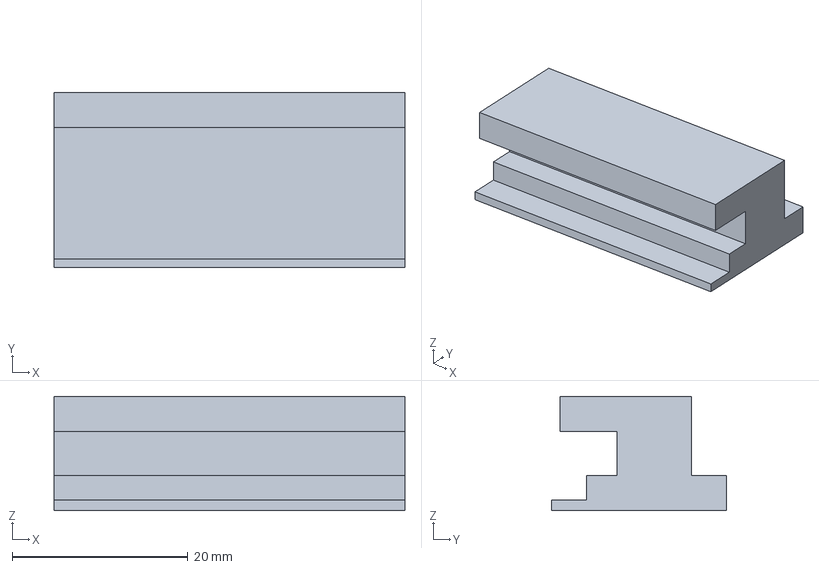
[picture p62: CAD file, 2026-10-13]
hardware/step/robot/04_gate_rail_coupon.step
40.0 x 20.0 x 13.0 mm
