LeoHougaard/robot-research-playground/(list of files, cad)

Other CAD files:
hardware/step/accessories/camera_assembly.step
hardware/native/accessories/electronics_assembly.FCStd
hardware/native/accessories/cable_assembly.FCStd
hardware/step/accessories/tether_assembly.step
hardware/step/accessories/operator_panel_assembly.step
hardware/native/robot/robot_playground_assembly.FCStd
hardware/prints/12_drive_wheel.stl
hardware/native/accessories/electronics_lid.FCStd
hardware/step/robot/16_caster_shim_10.step
hardware/native/robot/11_drive_servo_cradle.FCStd
hardware/step/robot/12_drive_wheel.step
hardware/native/robot/02_hole_clearance_coupon.FCStd
hardware/prints/11_drive_servo_cradle.stl
hardware/prints/20_moving_jaw.stl
hardware/step/accessories/cable_clamp_upper.step
hardware/native/robot/61_wall_joiner.FCStd
hardware/step/accessories/estop_clearance_ring.step
hardware/native/accessories/perfboard_carrier.FCStd
hardware/native/robot/31_tether_mast.FCStd
hardware/prints/41_object_marker_cap.stl
hardware/step/accessories/cable_clamp_lower.step
hardware/step/robot/03_servo_body_coupon.step
hardware/native/accessories/estop_panel_stand.FCStd
hardware/prints/31_tether_mast.stl
hardware/step/accessories/tether_anchor_plate.step
hardware/native/accessories/beam_clamp_lower.FCStd
hardware/step/robot/22_gripper_servo_tower.step
hardware/step/accessories/electronics_box.step
hardware/native/accessories/terminal_guard.FCStd
hardware/native/robot/42_calibration_marker_base.FCStd
hardware/prints/50_gate_base.stl
hardware/step/accessories/beam_clamp_lower.step
hardware/step/robot/62_arena_corner.step
hardware/native/robot/41_object_marker_cap.FCStd
hardware/step/accessories/estop_panel.step
hardware/step/robot/30_marker_tower.step
hardware/native/robot/20_moving_jaw.FCStd
hardware/prints/14_caster_spacer.stl
hardware/step/accessories/beam_clamp_upper.step
hardware/native/accessories/cable_clamp_upper.FCStd
hardware/native/robot/62_arena_corner.FCStd
hardware/prints/60_arena_wall_200.stl
hardware/step/robot/14_caster_spacer.step
hardware/native/accessories/camera_plate.FCStd
hardware/native/robot/04_gate_rail_coupon.FCStd
hardware/prints/30_marker_tower.stl
hardware/step/robot/21_fixed_jaw.step
hardware/native/robot/03_servo_body_coupon.FCStd
hardware/prints/16_caster_shim_10.stl
hardware/step/robot/60_arena_wall_200.step
hardware/native/robot/32_overhead_tie_plate.FCStd
hardware/prints/51_gate_slider.stl
hardware/step/robot/40_puck.step
hardware/native/robot/05_gate_runner_coupon.FCStd
hardware/prints/10_chassis.stl
hardware/step/robot/52_gate_end_stop.step
hardware/native/robot/40_puck.FCStd
hardware/prints/61_wall_joiner.stl
hardware/step/robot/32_overhead_tie_plate.step
hardware/native/robot/50_gate_base.FCStd
hardware/prints/15_caster_shim_05.stl
hardware/step/robot/02_hole_clearance_coupon.step
hardware/native/robot/15_caster_shim_05.FCStd
hardware/prints/01_horn_fit_coupon.stl
hardware/step/robot/51_gate_slider.step
hardware/native/robot/22_gripper_servo_tower.FCStd
hardware/prints/42_calibration_marker_base.stl
hardware/step/robot/05_gate_runner_coupon.step
hardware/native/robot/21_fixed_jaw.FCStd
hardware/prints/52_gate_end_stop.stl
hardware/step/robot/01_horn_fit_coupon.step
hardware/native/robot/13_tpu_tire.FCStd
hardware/prints/04_gate_rail_coupon.stl
hardware/step/robot/13_tpu_tire.step
hardware/step/robot/10_chassis.step
hardware/prints/accessories/beam_clamp_lower.stl
hardware/prints/accessories/beam_clamp_upper.stl
hardware/prints/accessories/cable_clamp_lower.stl
hardware/prints/accessories/cable_clamp_upper.stl
hardware/prints/accessories/camera_plate.stl
hardware/prints/accessories/electronics_box.stl
hardware/prints/accessories/electronics_lid.stl
hardware/prints/accessories/estop_clearance_ring.stl
hardware/prints/accessories/estop_panel.stl
hardware/prints/accessories/estop_panel_stand.stl
hardware/prints/accessories/perfboard_carrier.stl
hardware/prints/accessories/terminal_guard.stl
hardware/prints/accessories/tether_anchor_plate.stl
