LeoHougaard/robot-research-playground/hardware/prints/accessories/cable-assembly.png

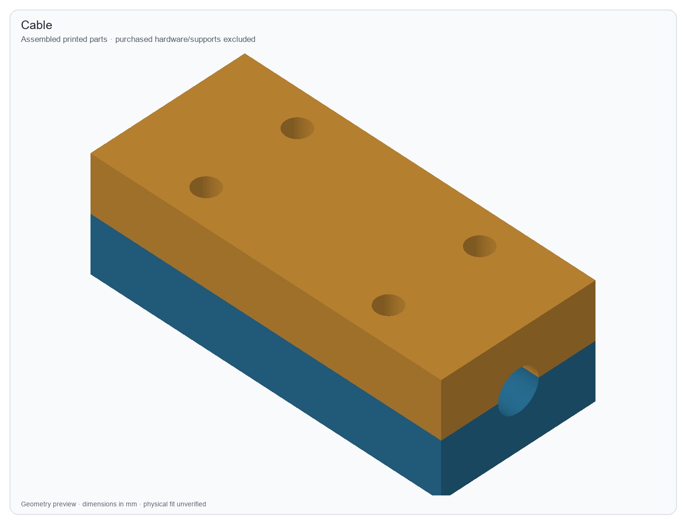
hardware/prints/accessories/cable-assembly.png
