LeoHougaard/robot-research-playground/hardware/prints/accessories/electronics-assembly.png

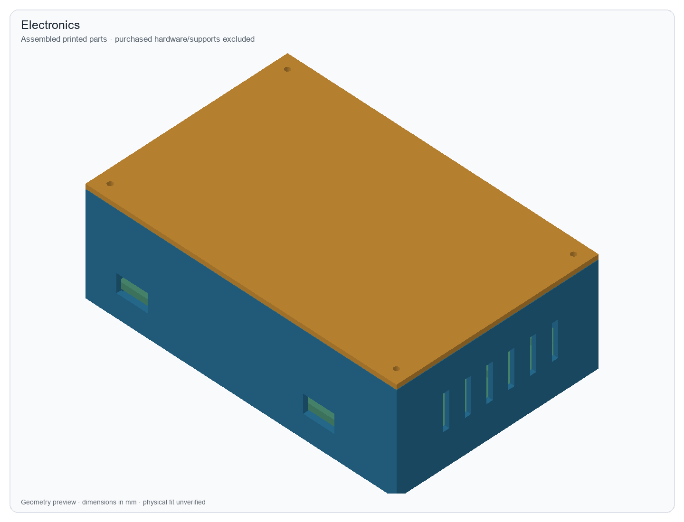
hardware/prints/accessories/electronics-assembly.png
