LeoHougaard/robot-research-playground/hardware/prints/accessories/operator-panel-labels.png

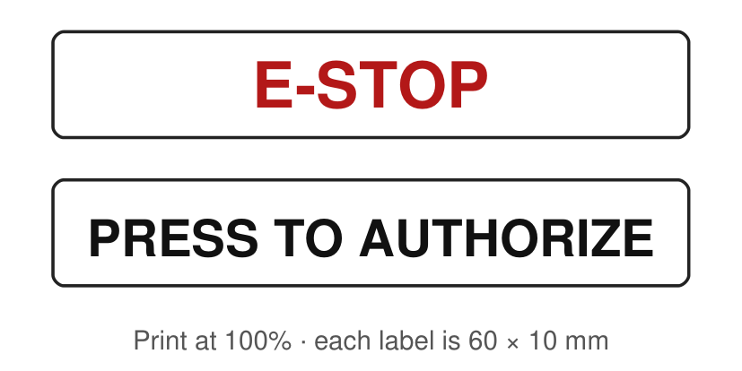
hardware/prints/accessories/operator-panel-labels.png
