LeoHougaard/robot-research-playground/hardware/prints/accessories/tether-assembly.png

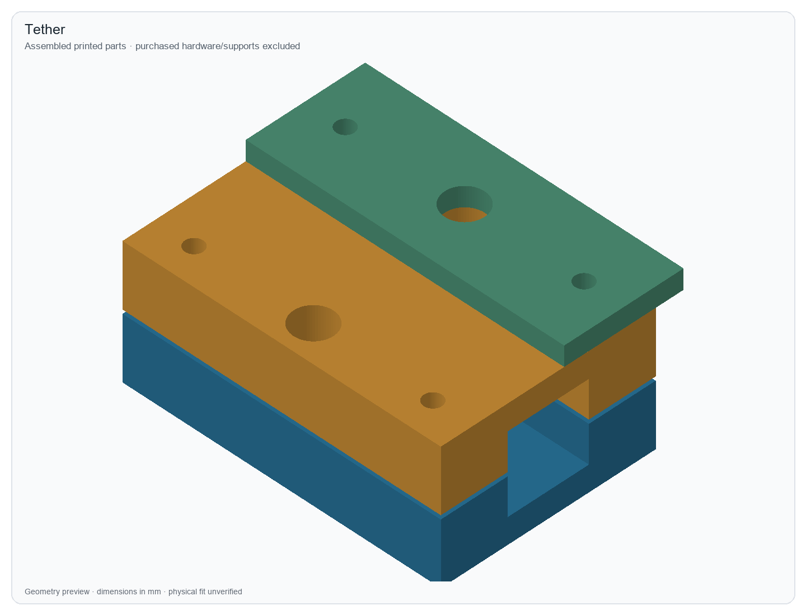
hardware/prints/accessories/tether-assembly.png
