LeoHougaard/robot-research-playground/hardware/prints/arena_layout.png

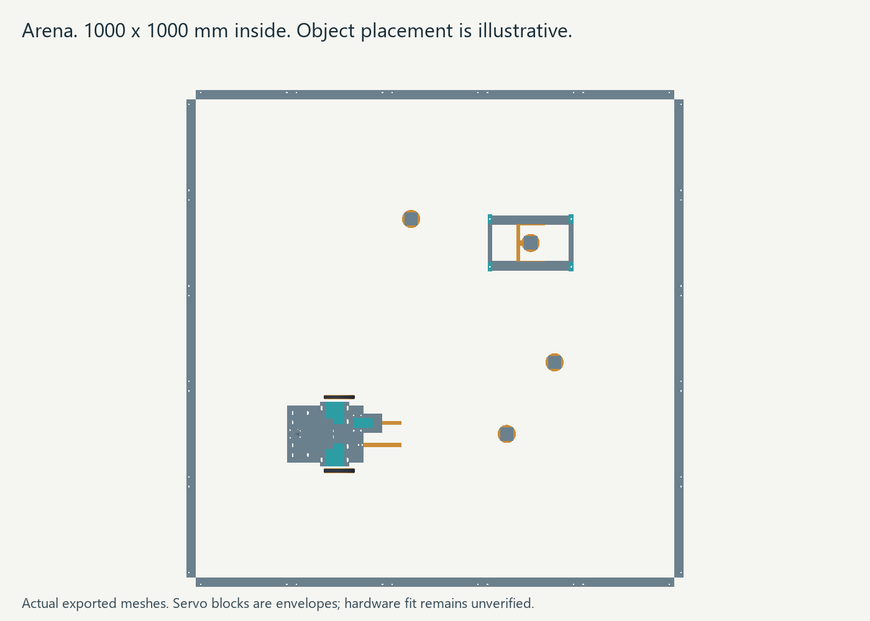
hardware/prints/arena_layout.png
