LeoHougaard/robot-research-playground/hardware/prints/robot_gate_grasp.png

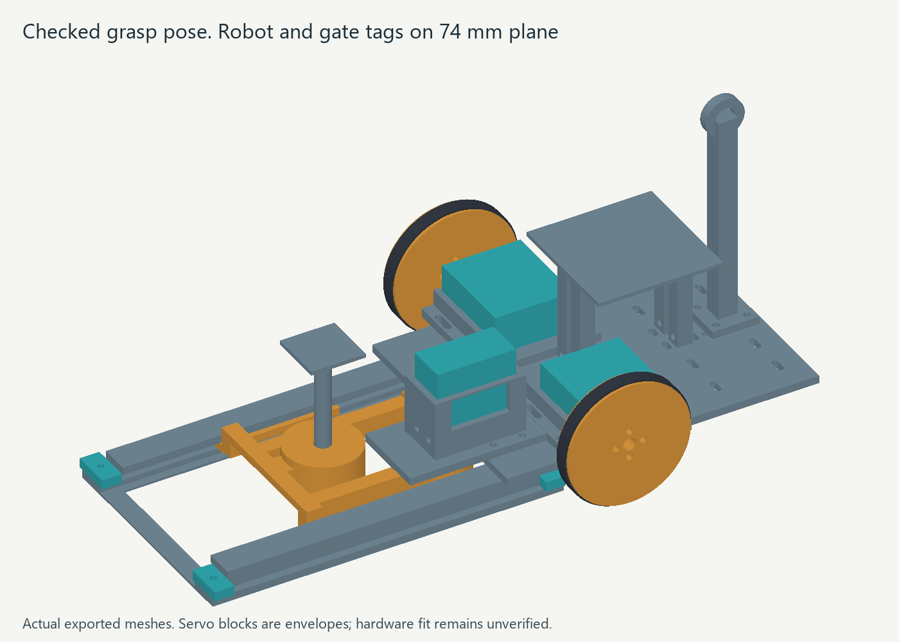
hardware/prints/robot_gate_grasp.png
