LeoHougaard/robot-research-playground/hardware/prints/robot_open_jaw.png

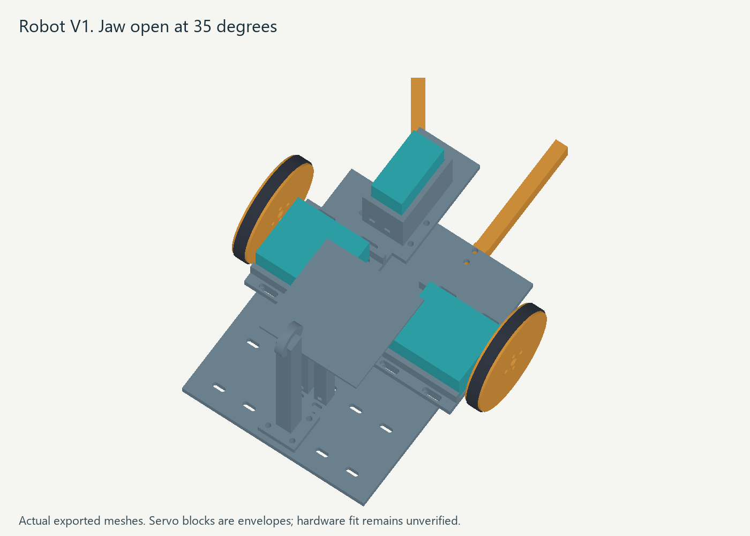
hardware/prints/robot_open_jaw.png
