LeoHougaard/robot-research-playground/hardware/prints/robot_top.png

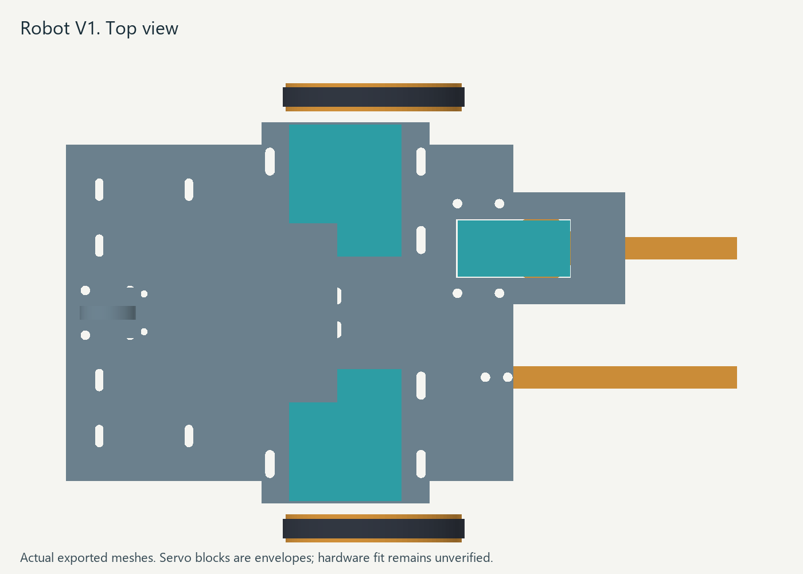
hardware/prints/robot_top.png
