LeoHougaard/robot-research-playground/hardware/prints/calibration-crosshairs-a4-300dpi.png

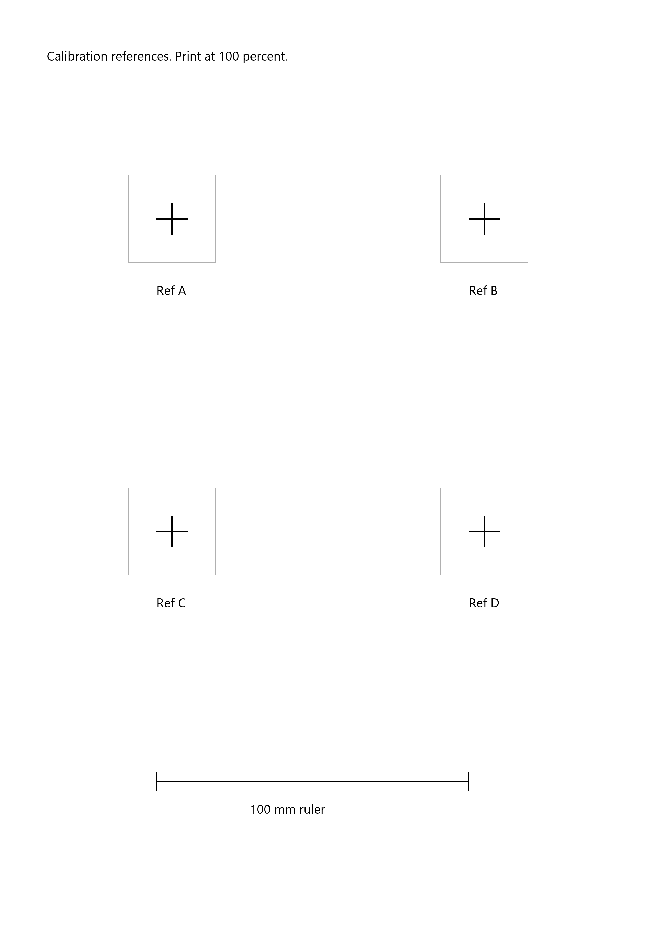
hardware/prints/calibration-crosshairs-a4-300dpi.png
