LeoHougaard/robot-research-playground/src/playground/state.py

"""One supervisor per evidence directory, released on process exit."""
from pathlib import Path
import os


class StateLock:
    def __init__(self, directory):
        Path(directory).mkdir(parents=True, exist_ok=True)
        self.file = open(Path(directory) / "supervisor.lock", "a+b")
        try:
            if os.name == "nt":
                import msvcrt
                self.file.seek(0)
                if not self.file.read(1):
                    self.file.write(b"0")
                    self.file.flush()
                self.file.seek(0)
                msvcrt.locking(self.file.fileno(), msvcrt.LK_NBLCK, 1)
            else:
                import fcntl
                fcntl.flock(self.file.fileno(), fcntl.LOCK_EX | fcntl.LOCK_NB)
        except OSError as exc:
            self.file.close()
            raise RuntimeError("Another supervisor owns this state directory") from exc

    def close(self):
        if self.file.closed:
            return
        if os.name == "nt":
            import msvcrt
            self.file.seek(0)
            msvcrt.locking(self.file.fileno(), msvcrt.LK_UNLCK, 1)
        else:
            import fcntl
            fcntl.flock(self.file.fileno(), fcntl.LOCK_UN)
        self.file.close()
