LeoHougaard/robot-research-playground/(commit log)

2026-10-13 Build robot playground implementation and verified handoff
    [01_horn_fit_coupon.stl, 02_hole_clearance_coupon.stl, 03_servo_body_coupon.stl, 04_gate_rail_coupon.stl, 05_gate_runner_coupon.stl, 10_chassis.stl, 11_drive_servo_cradle.stl, 12_drive_wheel.stl]
2026-10-13 Add editable FreeCAD and STEP build with verified print assets
    [01_horn_fit_coupon.FCStd, 01_horn_fit_coupon.step, 02_hole_clearance_coupon.FCStd, 02_hole_clearance_coupon.step, 03_servo_body_coupon.FCStd, 03_servo_body_coupon.step, 04_gate_rail_coupon.FCStd, 04_gate_rail_coupon.step]
2026-10-13 Preserve CAD checksums and Linux launcher line endings
2026-10-13 Fix independent endurance, isolation and physical control findings
    [cli.py, jobs.py, main.cpp, research.py, robot.py]
